hartikap/ProjectWork/README.md

# ProjectWork
Ohjelmistokehitys-koulutuksen projektityö
