hartikap/ProjectWork/Linkkejä.txt

USB-funktio generaattori:
http://tuomasnylund.fi/drupal6/content/ad9833-based-usb-function-generator
- Voisi liittää suoraan raspberryyn
	-> Python koodi tms ohjaamiseen

Patchwerk: Multi-User Network Control of a Massive Modular Synthesizer:
http://www.nime.org/proceedings/2012/nime2012_293.pdf

real-time communication protocol (full-duplex)
https://en.wikipedia.org/wiki/WebSocket

Raspberry pi documentation:
https://www.raspberrypi.org/documentation/hardware/raspberrypi/
I2S on raspi:
http://www.tjaekel.com/T-DAC/files/RPi-Bplus_guideline.pdf

Eurorack specs and examples:
http://www.doepfer.de/DIY/a100_diy.htm

https://www.thonk.co.uk/shop/caserail/
http://www.sdiy.info/w/Eurorack_DIY_parts
http://clicksclocks.de/
http://www.thomann.de/fi/doepfer_a100_diy_kit_1.htm
http://www.thomann.de/fi/doepfer_kabelsatz_fuer_diy_synth_kit.htm
http://www.instructables.com/id/Build-your-own-low-cost-Eurorack-Suitcase/

Eurorack explained:
https://www.youtube.com/watch?v=SBTiaGG6T6A

On synthesizer theory&applications:
http://electronotes.netfirms.com/free.htm

VCO:
http://www.birthofasynth.com/Thomas_Henry/Pages/VCO-1.html#Voltage_Controlled_Oscillator:_VCO-1

Making PCBs:
http://www.electricstuff.co.uk/pcbs.html
