hartikap/ProjectWork/WWWAMS_block-diagram1.pdf

Web Application -controlled Analog Modular Synthesizer (”WAMS”)

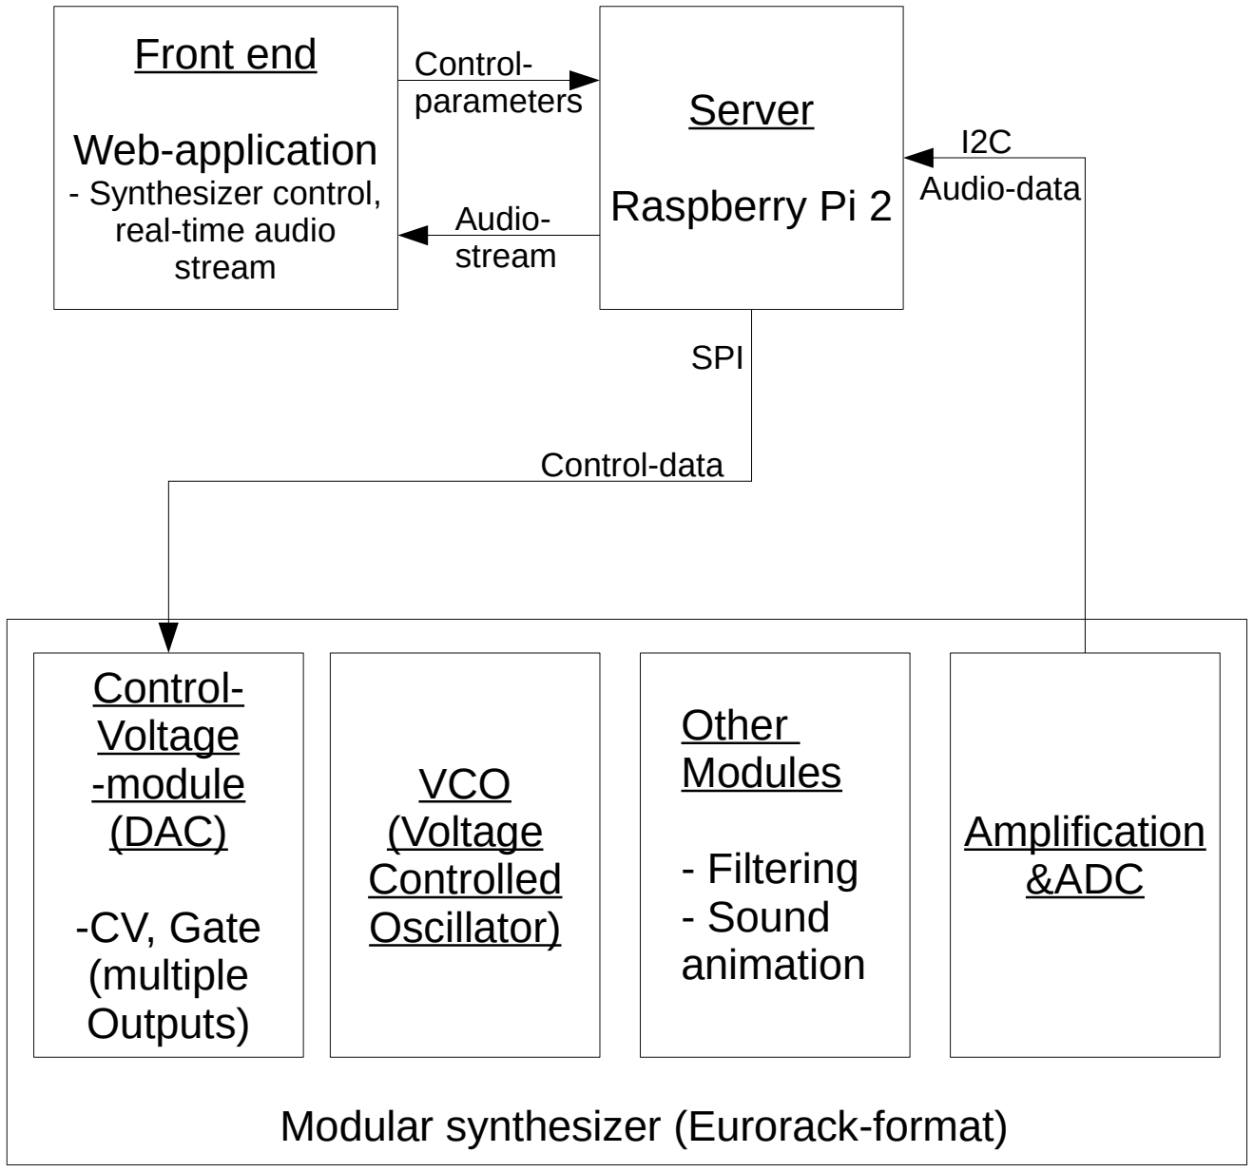
[picture p1: figure]
Front end; Web-application - Synthesizer control, real-time audio stream; Server; Raspberry Pi 2; Control- Voltage -module (DAC); -CV, Gate (multiple Outputs); VCO (Voltage Controlled Oscillator); SPI; Audio- stream; Control- parameters; Amplification &ADC; Modular synthesizer (Eurorack-format); Other Modules; - Filtering - Sound animation; Audio-data; Control-data
