hartikap/ProjectWork/Hardware/VCO-1/VCO1_PCB-layout.pdf

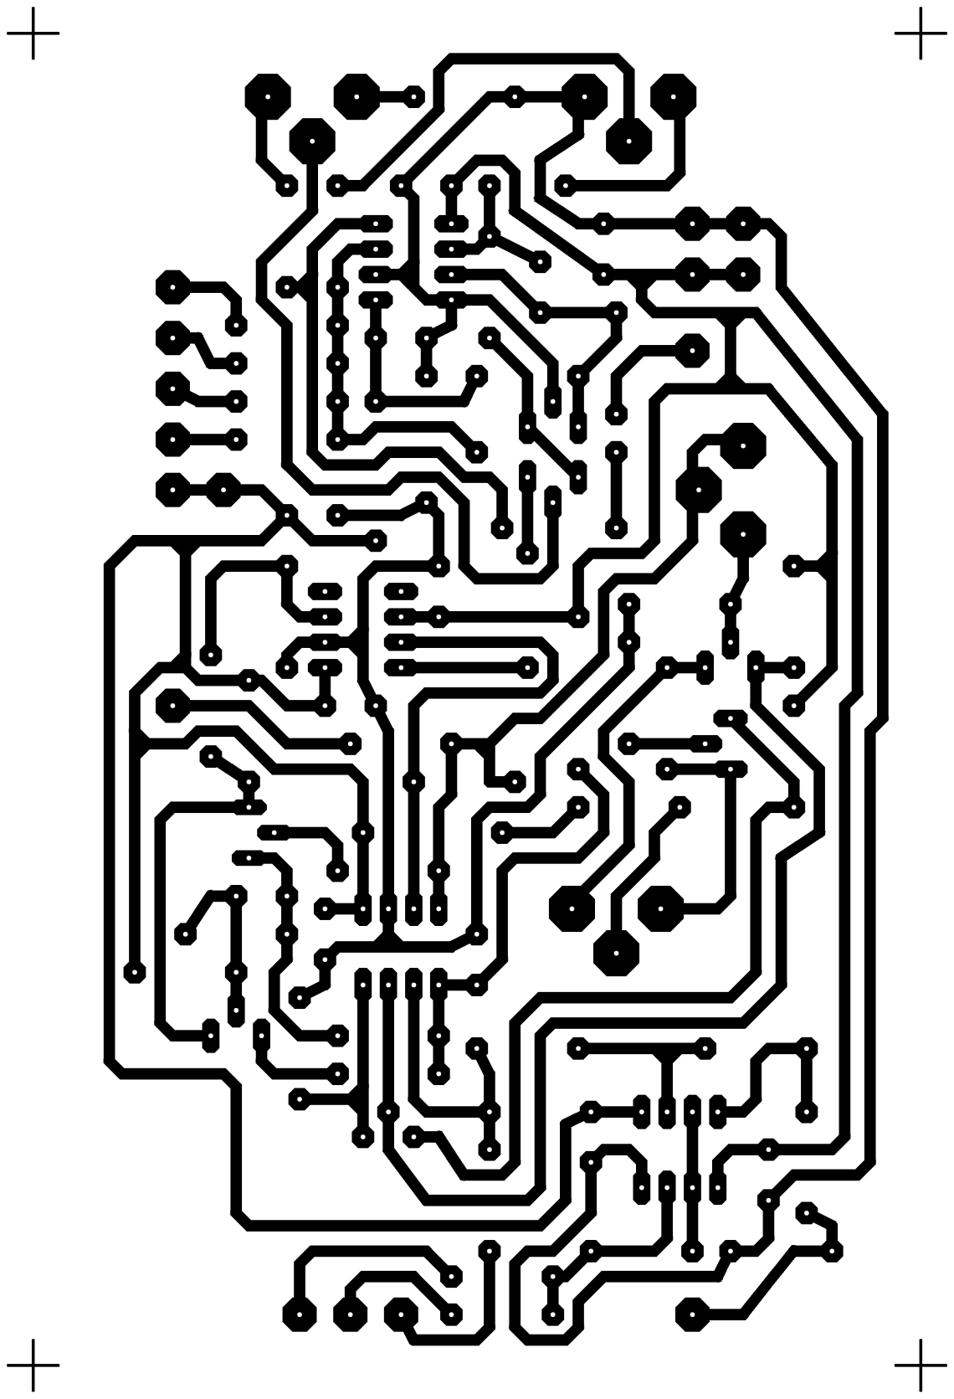
[picture p2: figure]
