hartikap/ProjectWork/Hardware/ADC-Board/Bottom.png

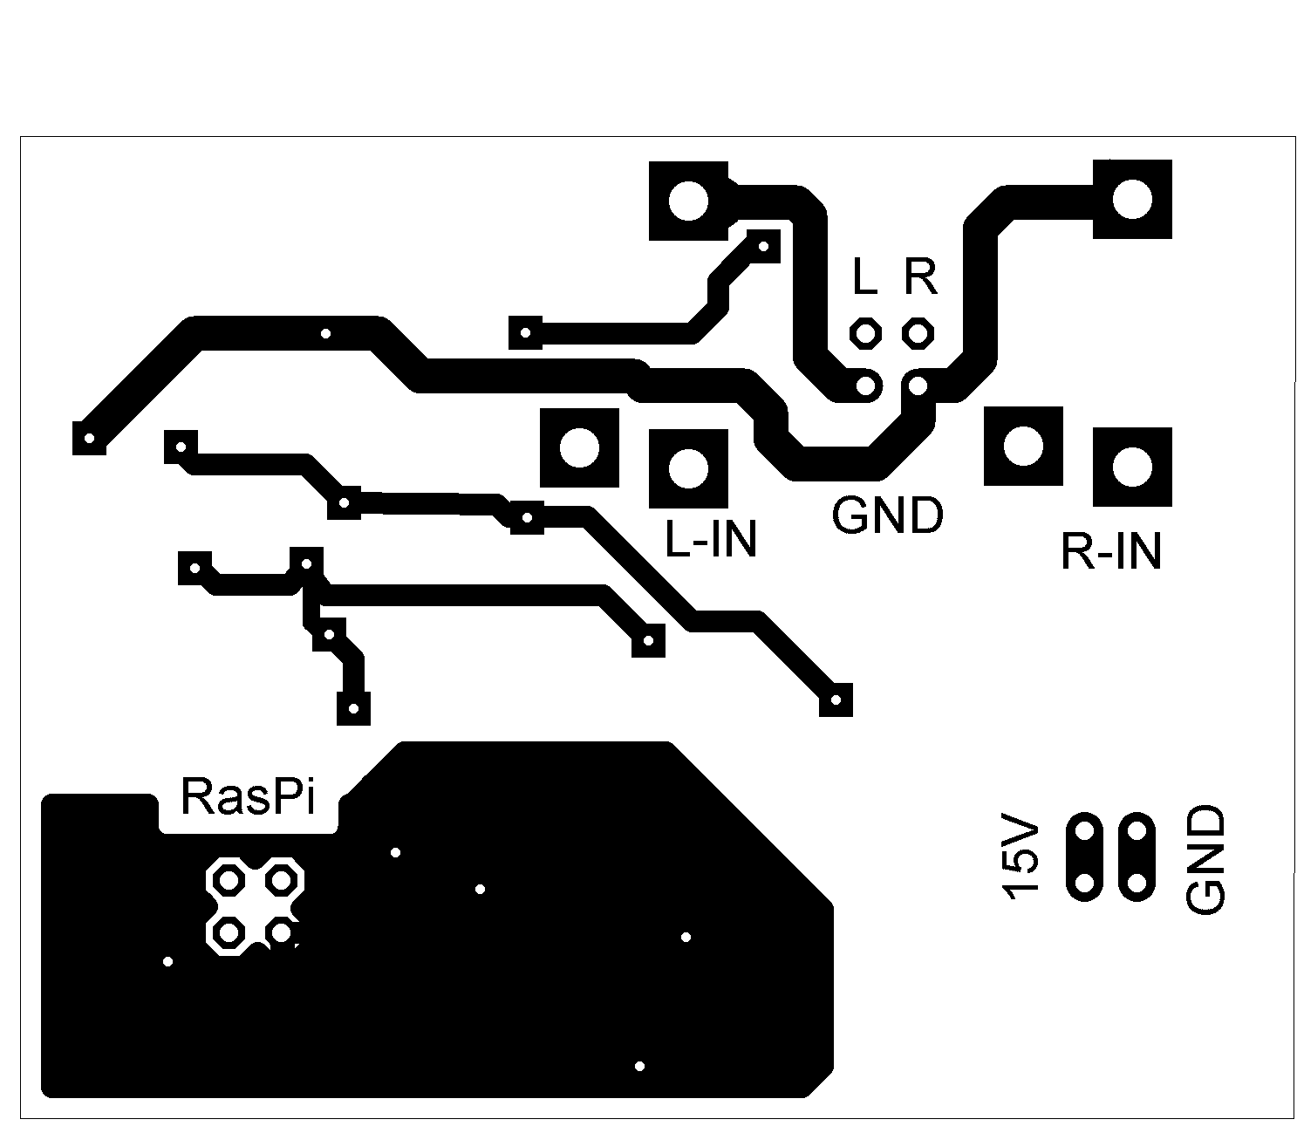
Hardware/ADC-Board/Bottom.png
