hartikap/ProjectWork/Hardware/ADC-Board/Placing.png

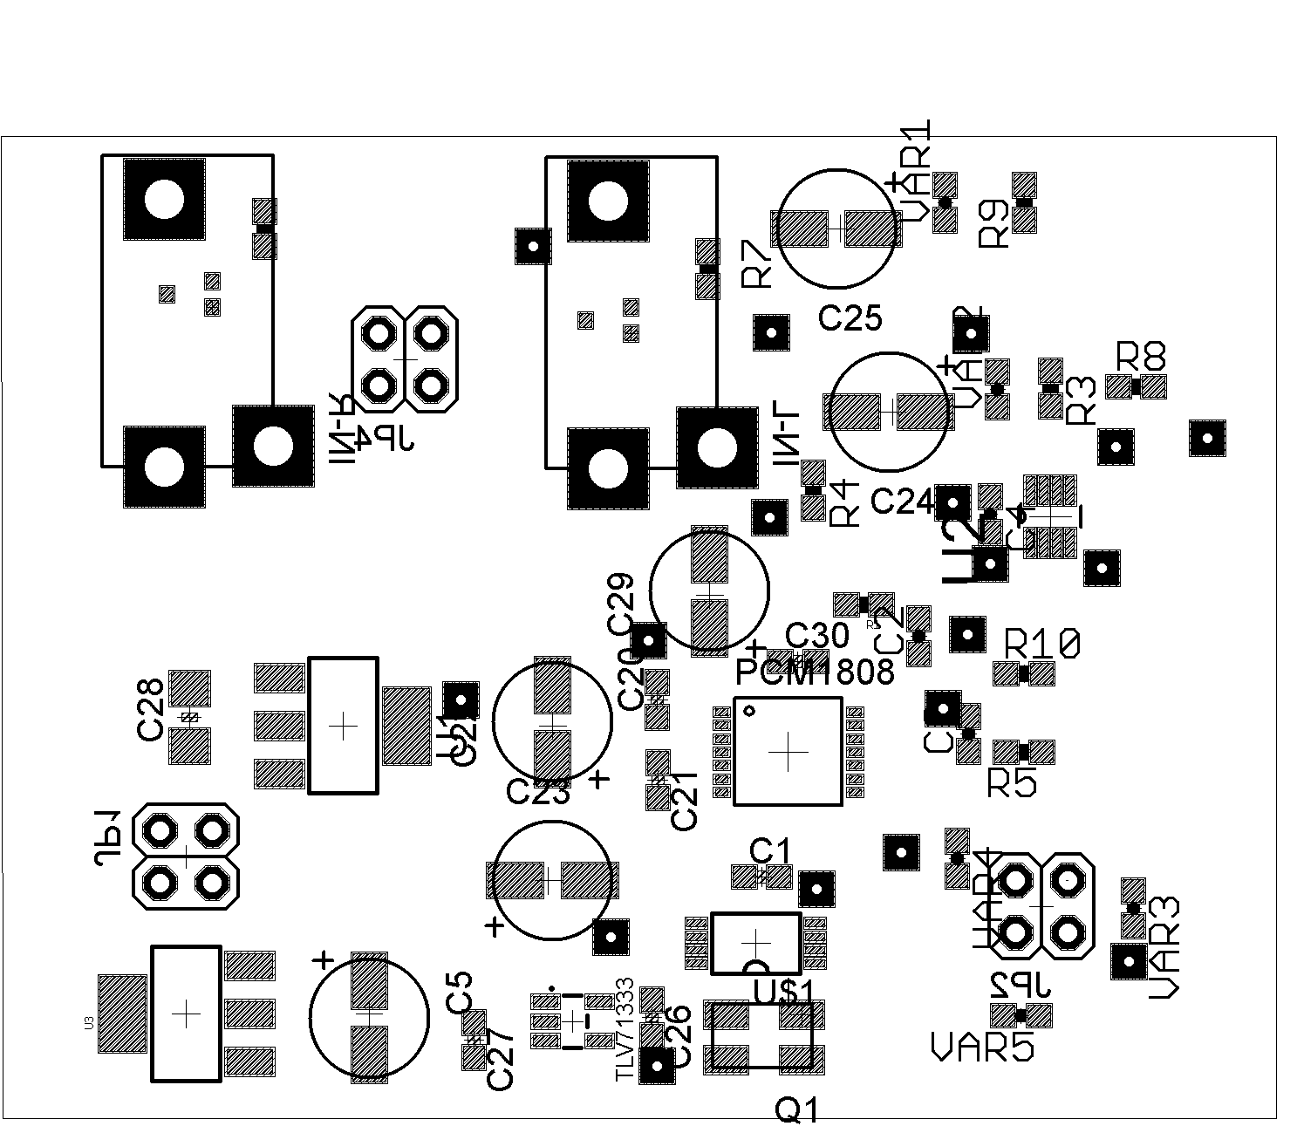
Hardware/ADC-Board/Placing.png
