hartikap/ProjectWork/Hardware/ADC-Board/schematics.png

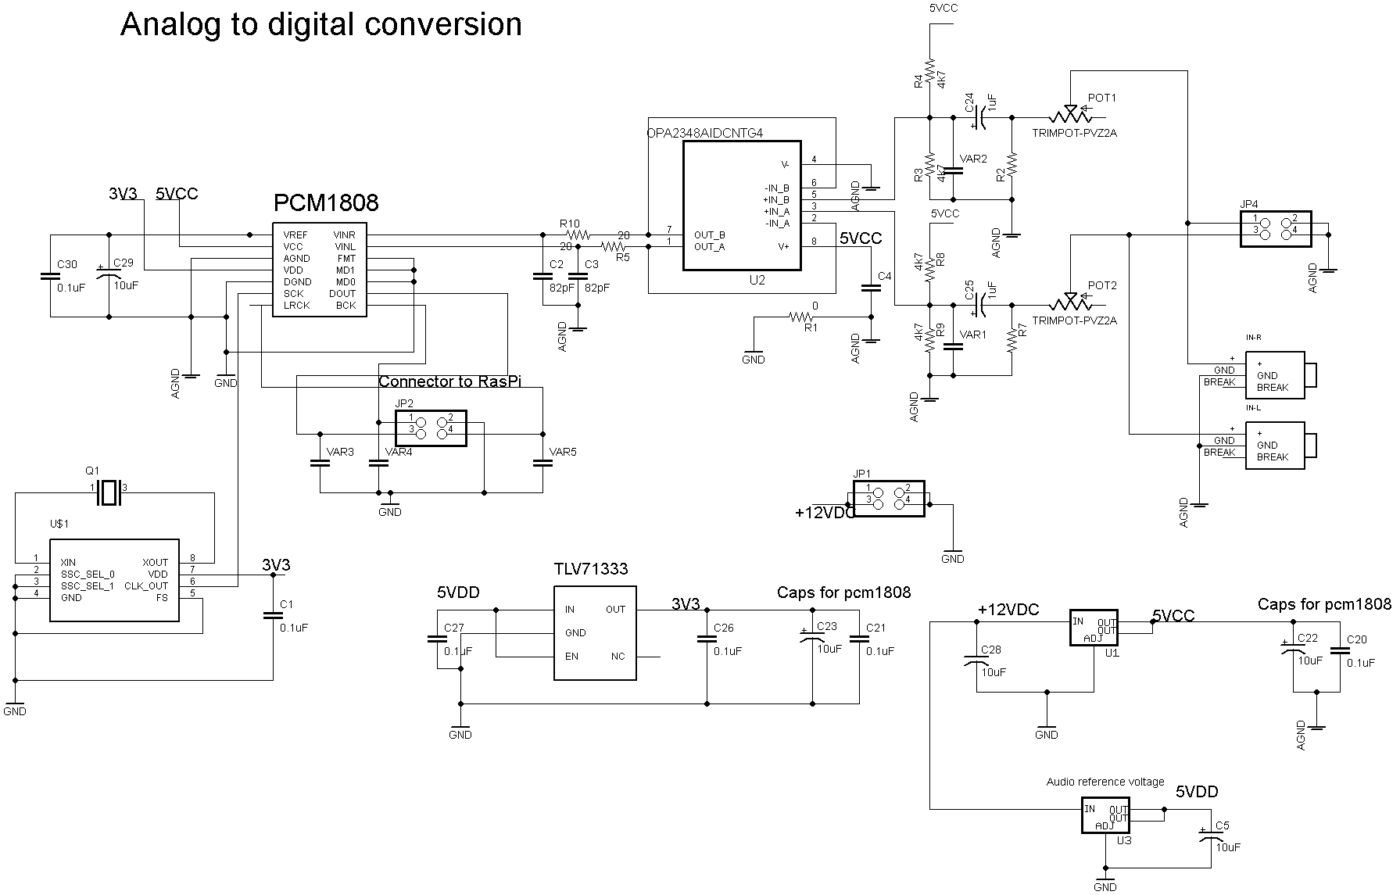
Hardware/ADC-Board/schematics.png
