hartikap/ProjectWork/Hardware/ADC-Board/Top.png

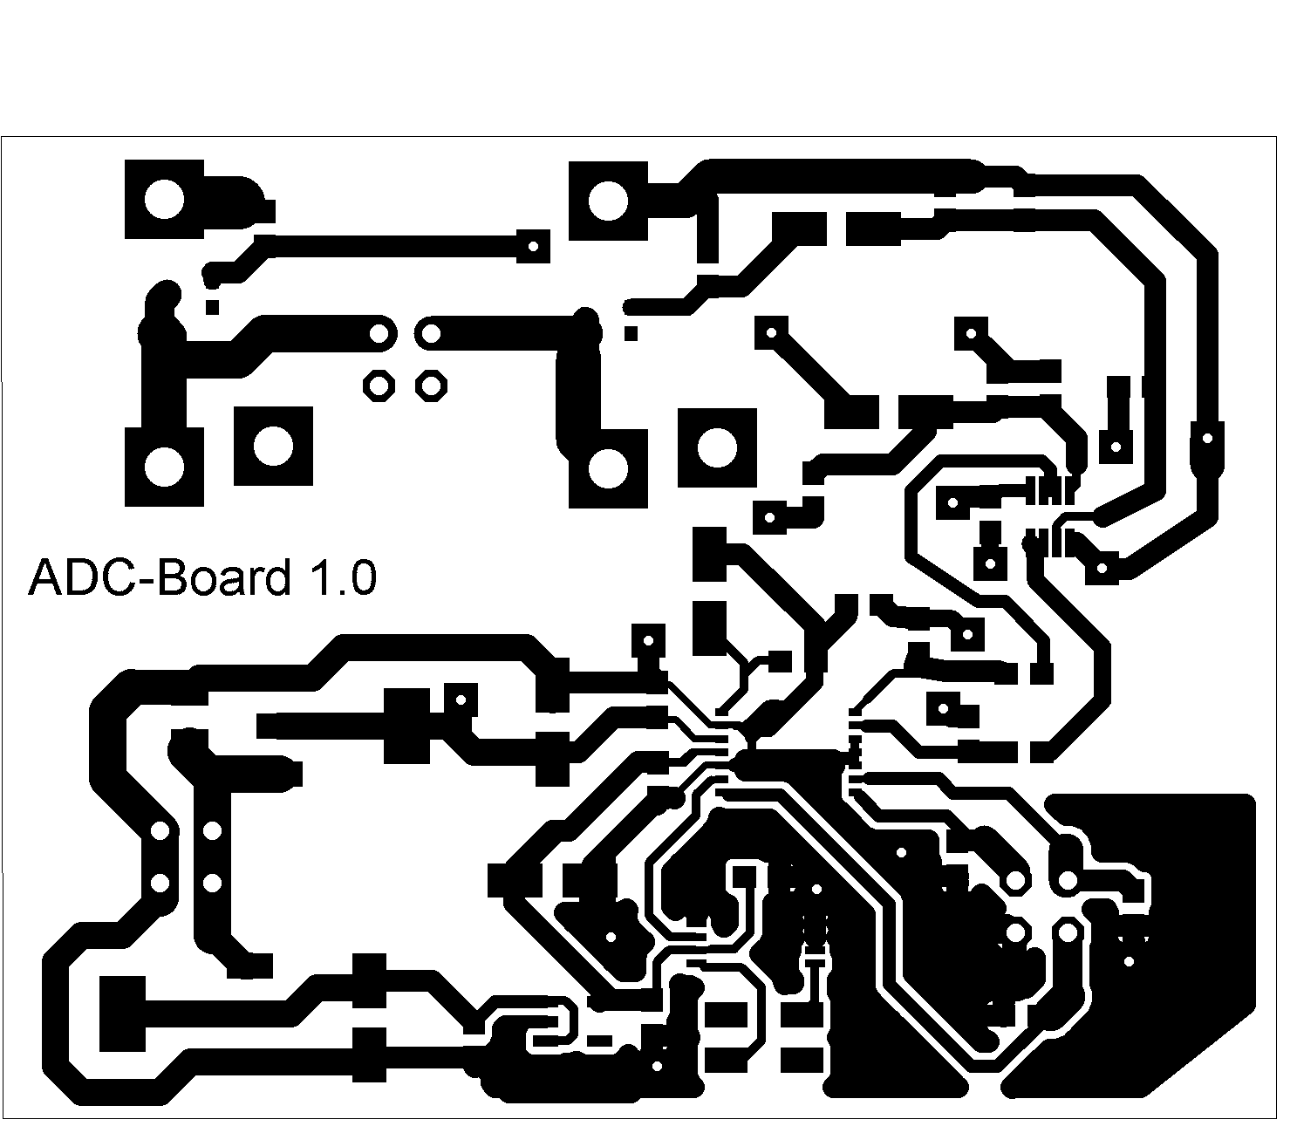
Hardware/ADC-Board/Top.png
