hartikap/ProjectWork/Hardware/CV-voltage conditioning/Bottom.png

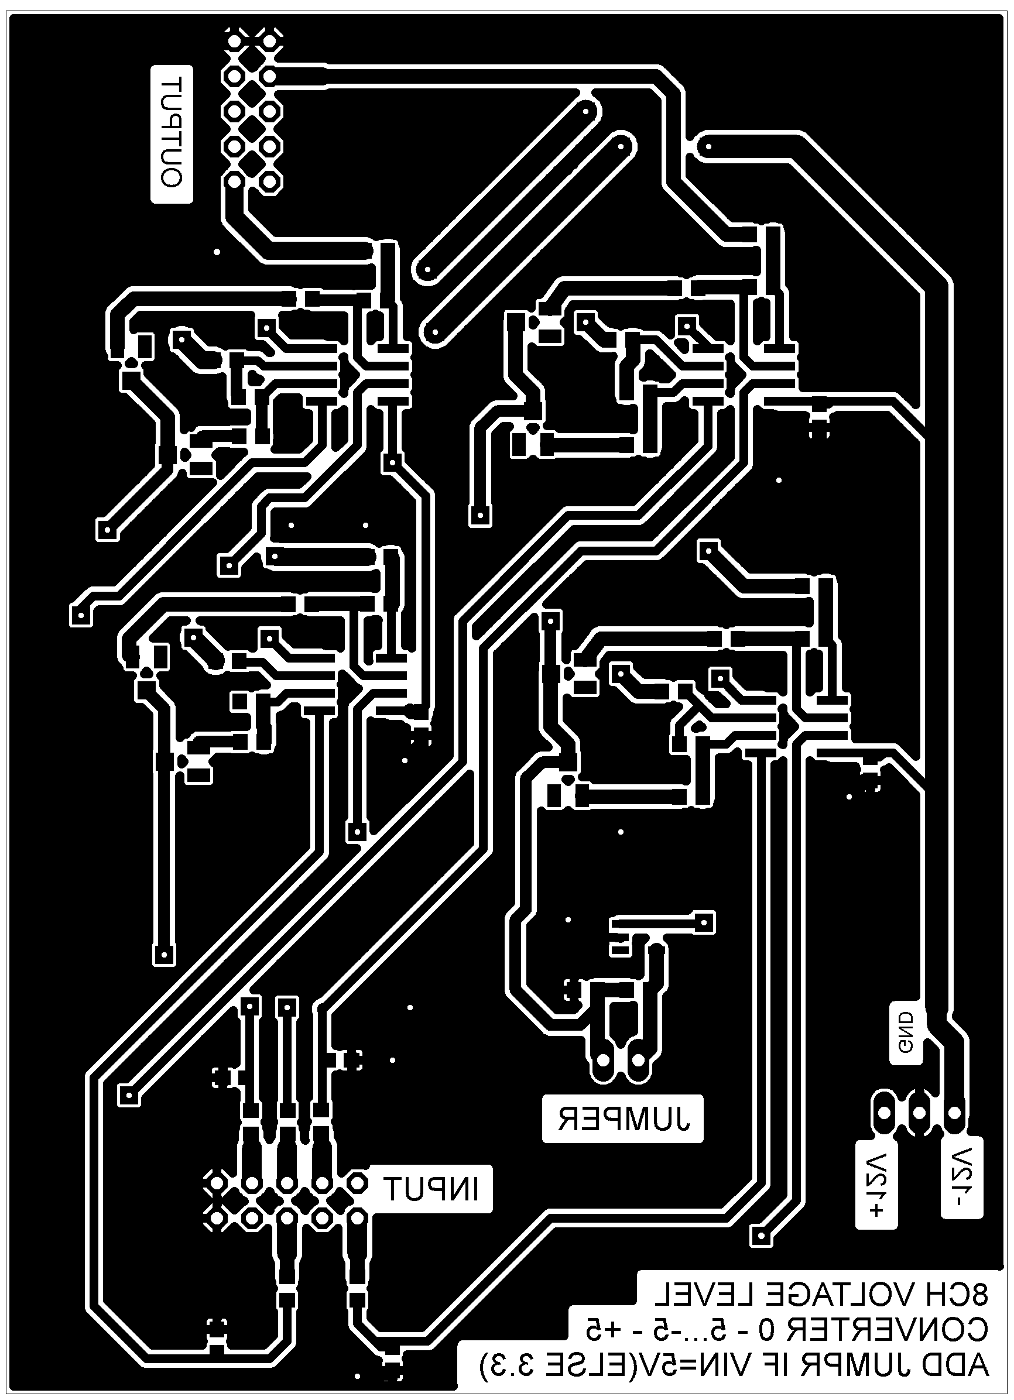
Hardware/CV-voltage conditioning/Bottom.png
