hartikap/ProjectWork/Hardware/CV-voltage conditioning/Bottom_placement.png

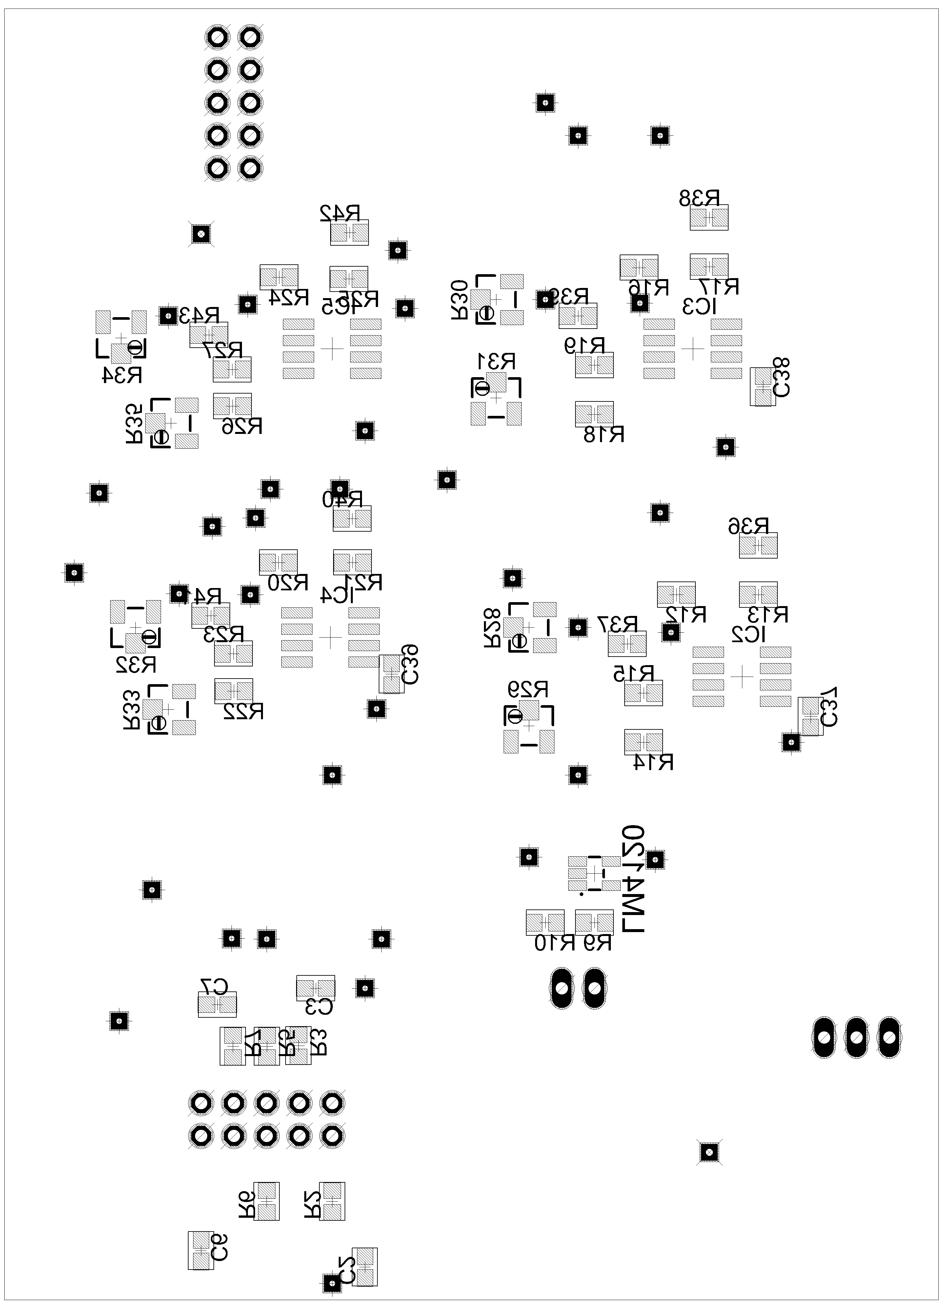
Hardware/CV-voltage conditioning/Bottom_placement.png
