hartikap/ProjectWork/Hardware/Farnell-parts.ods

Farnell order-list
For CV-module: | Order id | amount | Price/pc | Price total | datasheet
MCP4726A0T-E/CH Digital to Analogue Converter, 12 bit, Serial, 2.7V to 5.5V, SOT-23, 6 | 1925047 | 1 | 0,997 | 0,997 | http://www.farnell.com/datasheets/1780742.pdf
LM358ADR OP AMP, DUAL LOW POWER, SOIC8 | 7527007 | 20 | 0,1015 | 2,03 | http://www.farnell.com/datasheets/1874566.pdf
LM4120IM5-5.0/NOPB Voltage Reference | 2400687 | 2 | 1,05 | 2,1 | http://www.farnell.com/datasheets/1882702.pdf
Surface Mount Tantalum Capacitor, T491 Series, 10 µF, ± 10%, 16 V, 1206 | 1457414 | 5 | 0,318 | 1,59
SMD Multilayer Ceramic Capacitor, 0.022 µF, ± 10%, X5R, 10 V, 0603 | 2112848 | 10 | 0,0673 | 0,673
SMD Multilayer Ceramic Capacitor, 0.1 µF, ± 10%, X5R, 10 V, 0603 | 2470450 | 40 | 0,0311 | 1,244
AC/DC Power Supply, Raspberry Pi, Euro, 90 V, 264 V, 5 W, 5 V, 1 A | 2254794 | 1 | 4,03 | 4,03
Analogue to Digital Converter, 24 bit, 96 kSPS | 1754965 | 1 | 2,22 | 2,22 | http://www.farnell.com/datasheets/1764047.pdf
Surface Mount Chip Resistor, Thick Film, RC Series, 100 kohm, 0603 | 2309107 | 50 | 0,0033 | 0,165
Surface Mount Chip Resistor, Thick Film, RC Series, 1 kohm, 0603 | 2309108 | 50 | 0,0047 | 0,235
Surface Mount Chip Resistor, Thick Film, MC Series, 10 kohm, 0603 | 9330399 | 50 | 0,012 | 0,6
POTENTIOMETER, 1KOHM | 2219385 | 8 | 0,25 | 2
SMD Resistor, Thick Film, MC Series, 9.53 kohm, 63 mW, ± 1%, 50 V | 1170887 | 20 | 0,014 | 0,28
Fixed LDO Voltage Regulator, 6.4V to 18V, 1.2V Dropout, 5Vout, 1Aout, sot223 | 1825292 | 2 | 0,571 | 1,142 | http://www.farnell.com/datasheets/1696797.pdf
Resistor, Thick Film, CR Series, 20 kohm, 100 mW, ± 1%, 50 V, 0603 | 2333523 | 30 | 0,0486 | 1,458
SMD Aluminium Electrolytic Capacitor, WCAP-ASLL Series, 1 µF, 50 V, Radial Can | 2466226 | 5 | 0,142 | 0,71
SMD Aluminium Electrolytic Capacitor, WCAP-ASLI Series, 10 µF, 16 V, Radial Can | 2466275 | 5 | 0,158 | 0,79
TLV71333PDBVR Fixed LDO Voltage Regulator, 1.4V to 5.5V, 230mV Dropout, 3.3Vout, 150mAout, SOT-23-5 | 2463932 | 5 | 0,197 | 0,985 | http://www.farnell.com/datasheets/1888877.pdf
CDCS502PW CLOCK GENERATOR, 32MHZ, TSSOP-8 | 2492599 | 1 | 2,66 | 2,66 | http://www.farnell.com/datasheets/1919071.pdf
XTAL, 12.288MHZ, 10PF, SMD, 5.0X3.2 | 1841966 | 1 | 1,11 | 1,11 | http://www.farnell.com/datasheets/1497890.pdf
XTAL, 16.384MHZ, 10PF, SMD, 5.0X3.2 | 1841980 | 1 | 0,865 | 0,865
XTAL, 18.432MHZ, 10PF, SMD, 5.0X3.2 | 1841985 | 1 | 0,659 | 0,659
VISHAY DALE XT49M-18M432 CRYSTAL 18.432MHZ | 1703594 | 1 | 0,352 | 0,352
PRO SIGNAL MJ-2235 Phone Audio Connector, Socket, 3.5 mm, 2, PCB Mount | 1267375 | 2 | 1,37 | 2,74
Surface Mount Chip Resistor, Thick Film, AEC-Q200 ERJ Series, 20 kohm, 100 mW, ± 1%, 75 V | 2059432 | 10 | 0,009 | 0,09
Surface Mount Chip Resistor, Thick Film, RC Series, 39 kohm, 100 mW, ± 1%, 50 V, 0603 | 9238670 | 10 | 0,0067 | 0,067
Header, 5, 2.54 mm, Tin Plated Contacts | 1022253 | 10 | 0,204 | 2,04
SMD Multilayer Ceramic Capacitor, 1 µF, ± 10%, X5R, 10 V, 0603 | 2496916 | 40 | 0,0126 | 0,504
Surface Mount Chip Resistor, Ceramic, MCMR Series, 4.7 kohm, 100 mW, ± 1%, 75 V, 0603 | 2073509 | 20 | 0,0156 | 0,312
 |  |  |  | 0
 |  |  |  | 0
For VCO-1: |  |  |  | 0
Rotary Potentiometer, Conductive Plastic, P160 Series, 100 kohm, Linear | 1760795 | 10 | 1,04 | 10,4
MULTICOMP CR-MS-2 KNOB, SOFT TOUCH, SPLINED SHAFT, YEL | 1440003 | 10 | 0,474 | 4,74
Rotary Potentiometer, Cermet, 93 Series, 100 ohm, Linear | 2321801 | 1 | 6,44 | 6,44
2N3904BU Bipolar (BJT) Single Transistor, NPN | 1700648 | 10 | 0,0982 | 0,982
2N3906 Bipolar (BJT) Single Transistor, High Speed Switching, PNP | 1574372 | 5 | 0,2 | 1
LM13700N/NOPB Transconductance Amplifier, Dual, 2, 18 V, 2 MHz, -5 V, 5 V, DIP | 1651866 | 2 | 1,47 | 2,94
TL072IP Operational Amplifier, Dual, 3 MHz, 2, 13 V/µs, 7V to 36V, DIP, 8 | 1459704 | 5 | 0,883 | 4,415
1000PF 1% 250V Film Capacitor, FSC/EX Series, 1000 pF, ± 1%, PS (Polystyrene), 250 V | 9520651 | 2 | 2,14 | 4,28
IC SOCKET, DIP, 8POS, TH | 2445620 | 10 | 0,205 | 2,05
Multilayer Ceramic Capacitor, Mono-Kap Series, 1000 pF, ± 5%, C0G / NP0, 50 V | 1141771 | 5 | 0,253 | 1,265
Multilayer Ceramic Capacitor, MC Series, 47 pF, ± 5%, C0G / NP0, 100 V | 2395776 | 10 | 0,0889 | 0,889
Multilayer Ceramic Capacitor, MC Series, 0.22 µF, ± 10%, X7R, 50 V | 2395774 | 5 | 0,164 | 0,82
Multilayer Ceramic Capacitor, Mono Axial, A Series, 0.01 µF, ± 10%, X7R, 50 V | 1902252 | 10 | 0,19 | 1,9
Through Hole Resistor, MRS25 Series, 47 ohm, 600 mW, ± 1%, 350 V, Axial Leaded | 9468510 | 10 | 0,0672 | 0,672
Through Hole Resistor, MF25 Series, 820 ohm, 250 mW, ± 1%, 250 V, Axial Leaded | 9342265 | 10 | 0,0776 | 0,776
Through Hole Resistor, LR Series, 1 kohm, 600 mW, ± 1%, 350 V, Axial Leaded | 2330035 | 10 | 0,063 | 0,63
Through Hole Resistor, LR Series, 2 kohm, 250 mW, ± 1%, 200 V, Axial Leaded | 2329911 | 10 | 0,053 | 0,53
Through Hole Resistor, CFR Series, 10 kohm, 250 mW, ± 5%, 200 V, Axial Leaded | 2329474 | 10 | 0,034 | 0,34
Through Hole Resistor, MF12 Series, 5.1 kohm, 125 mW, ± 1%, 200 V, Axial Leaded | 9343318 | 5 | 0,0245 | 0,1225
Through Hole Resistor, MFR Series, 18 kohm, 400 mW, ± 1%, 200 V, Axial Leaded | 1565285 | 10 | 0,034 | 0,34
Through Hole Resistor, MFR Series, 22 kohm, 400 mW, ± 1%, 200 V, Axial Leaded | 1565295 | 10 | 0,037 | 0,37
Through Hole Resistor, LR Series, 20 kohm, 250 mW, ± 1%, 200 V, Axial Leaded | 2329897 | 10 | 0,055 | 0,55
Through Hole Resistor, MFR Series, 27 kohm, 400 mW, ± 1%, 200 V, Axial Leaded | 1565299 | 10 | 0,0477 | 0,477
Through Hole Resistor, MFR Series, 100 kohm, 400 mW, ± 1%, 200 V, Axial Leaded | 1565269 | 10 | 0,037 | 0,37
Through Hole Resistor, MFR Series, 1 Mohm, 400 mW, ± 1%, 200 V, Axial Leaded | 1565292 | 10 | 0,037 | 0,37
Through Hole Resistor, CFR Series, 2.2 Mohm, 250 mW, ± 5%, 200 V, Axial Leaded | 2329510 | 10 | 0,034 | 0,34
Through Hole Resistor, CFR Series, 1.5 Mohm, 250 mW, ± 5%, 200 V, Axial Leaded | 2329492 | 10 | 0,037 | 0,37
Through Hole Resistor, CFR Series, 3.3 Mohm, 330 mW, ± 5%, 250 V, Axial Leaded | 2329676 | 10 | 0,0396 | 0,396
Phone Audio Connector, Socket, 3.5 mm, 2, Panel Mount | 1340604 | 16 | 0,766 | 12,256
TE CONNECTIVITY / CITEC LT300014T261K0J RESISTOR, TEMPERATURE SENSING, 1K | 1174306 | 2 | 1,08 | 2,16
 |  |  |  | 0
 |  |  |  | 0
 |  |  |  | 0
 |  |  |  | 0
 |  |  |  | 0
 |  |  |  | 0
 |  |  |  | 97,8385 | Total
Lisätilaus
SMD Multilayer Ceramic Capacitor, 0.1 µF, ± 10%, X7R, 50 V, 0603 | 2496834 | 40 | 0,0126 | 0,504
SMD Multilayer Ceramic Capacitor, 0.022 µF, ± 10%, X7R, 50 V, 0603 | 1658869 | 20 | 0,0336 | 0,672
MCP6002-I/P Operational Amplifier, Dual, 1 MHz, 2, 0.6 V/µs, 1.8V to 6V, DIP, 8 | 1292245 | 10 | 0,414 | 4,14
OPA2348AIDCNT Operational Amplifier, Dual, 1 MHz, 2, 0.5 V/µs, 2.1V to 5.5V, SOT-23, 8 | 1207098 | 4 | 0,852 | 3,408
VARISTOR,SUPP,ESD PROTECT,20V,0603 | 1838966 | 20 | 0,129 | 2,58
Surface Mount Chip Resistor, Thick Film, AEC-Q200 ERJ Series, 20 ohm, 100 mW, ± 1%, 75 V | 2059261 | 20 | 0,009 | 0,18
SMD Multilayer Ceramic Capacitor, MC Series, 82 pF, ± 5%, C0G / NP0, 50 V, 0603 [1608 Metric] | 1759065 | 10 | 0,0119 | 0,119
Surface Mount Chip Resistor, Ceramic, MCMR Series, 4.7 kohm, 100 mW, ± 1%, 75 V, 0603 | 2073509 | 30 | 0,0156 | 0,468
TRIMMER, SMD, 4K7 | 1771724 | 2 | 0,292 | 0,584
Through Hole Resistor, MFR Series, 75 ohm, 500 mW, ± 1%, 250 V, Axial Leaded | 1099864 | 50 | 0,0255 | 1,275
Through Hole Resistor, MFR Series, 47 ohm, 500 mW, ± 1%, 350 V, Axial Leaded | 1099858 | 20 | 0,0571 | 1,142
Electrolytic Capacitor, MCGPR Series, 22 µF, ± 20%, 25 V, 5 mm, Radial Leaded | 9451161 | 20 | 0,043 | 0,86
MOSFET Transistor, N Channel, 400 mA, 60 V, 1.2 ohm, 10 V, 2.1 V | 1017689 | 5 | 0,184 | 0,92
MOSFET Transistor, N Channel, 1.4 A, 30 V, 0.119 ohm, 10 V, 1.6 V | 2432720 | 5 | 0,0622 | 0,311
2N4401TF Bipolar (BJT) Single Transistor, NPN, 40 V, 250 MHz, 625 mW | 2453755 | 5 | 0,056 | 0,28
 |  |  |  | 0
 |  |  |  | 0
 |  |  |  | 17,443
Lisätilaus 2
50k potikka
Liitin muuntaja – PCB
