hartikap/ProjectWork/Hardware/VCO-1/VCO1_Parts_Placement.pdf

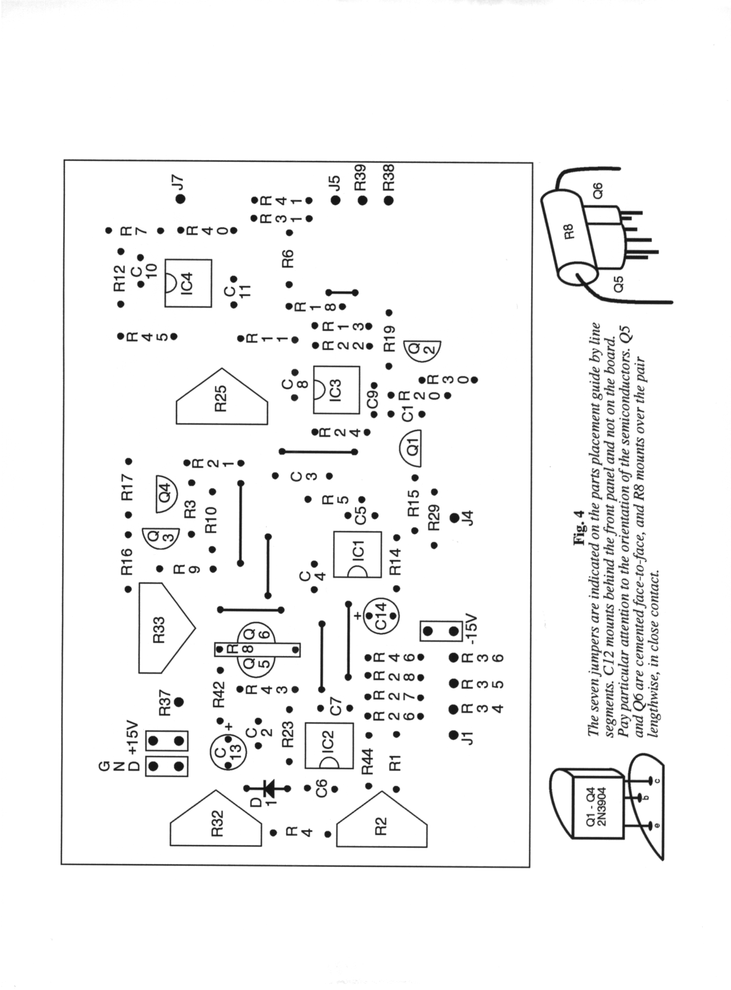
[picture p9: page 1]
