hartikap/ProjectWork/Hardware/ADC-Board/ADC-Board-schematics.brd

## EAGLE design Hardware/ADC-Board/ADC-Board-schematics.brd (2016-03-11)

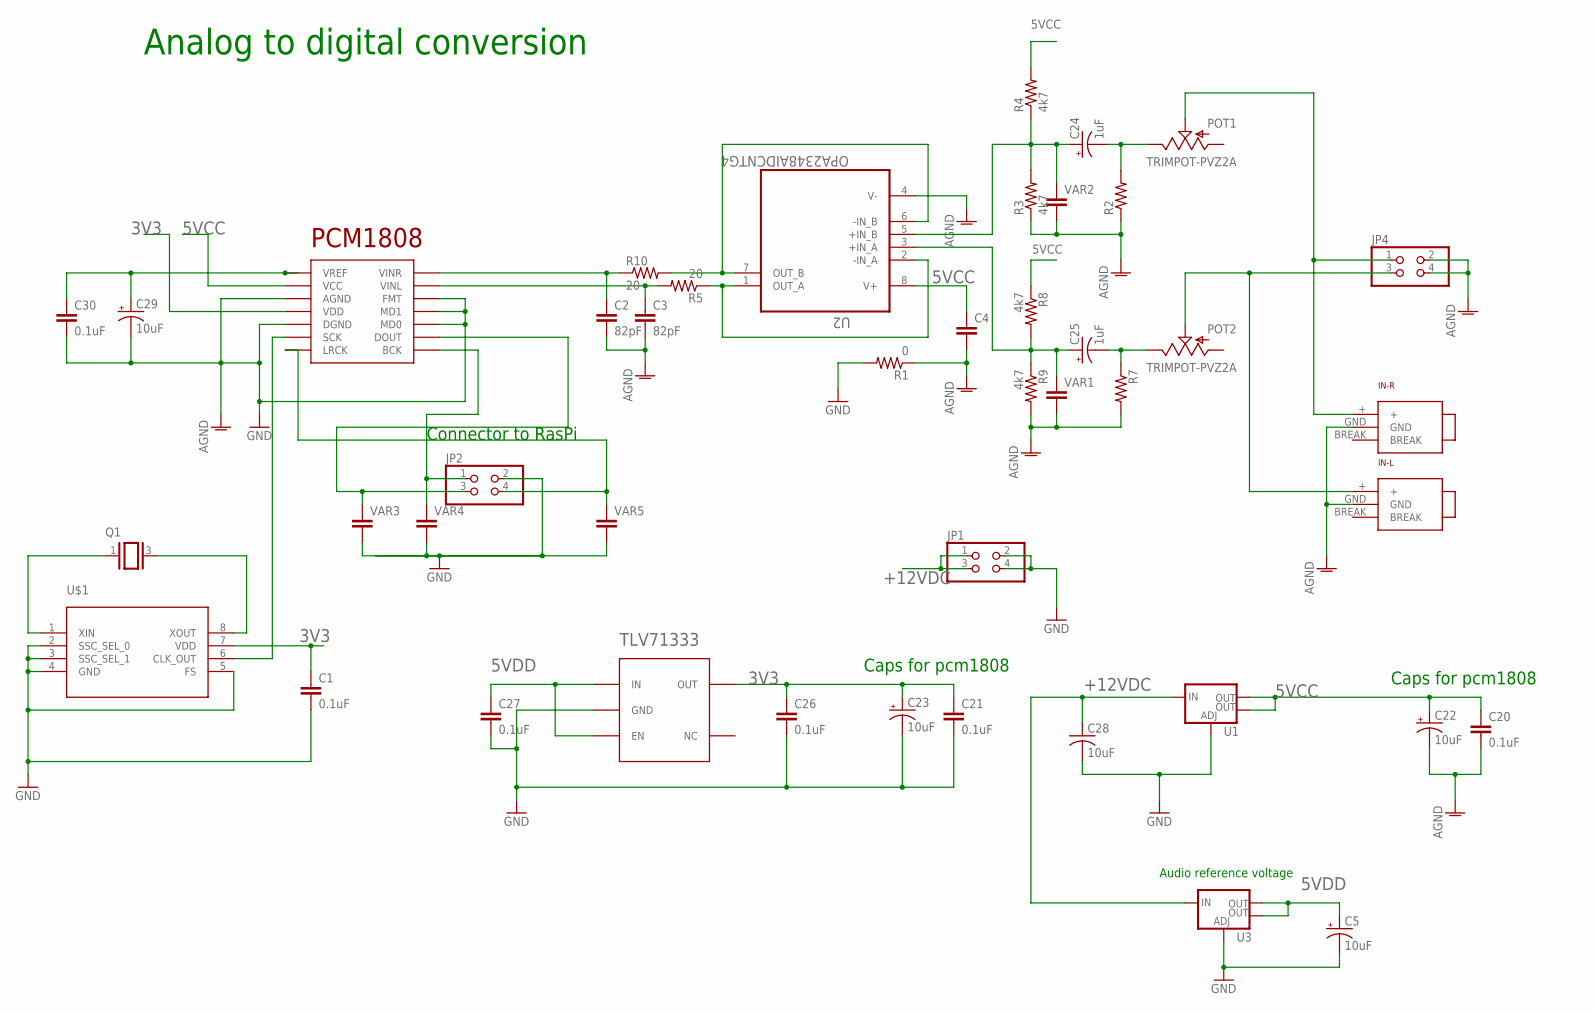
[picture p10: schematic ADC-Board-schematics.sch]

Parts:
C1, C20, C21, C26, C27, C30: 0.1uF; C0603
C2, C3: 82pF; 0603-CAP
C4: CAP0603-CAP; 0603-CAP
C5, C22, C23, C29: 10uF; RADIALCAN4MM
C24, C25: 1uF; RADIALCAN4MM
C28: 10uF; C1206
IN-L: 3MM5-PLUG
IN-R: 3MM5-PLUG
JP1, JP2, JP4: PINHD-2X2; 2X02
PCM1808: PCM1808PW; R-PDSO-G14
POT1, POT2: TRIMPOT-PVZ2A; PVZ2A
Q1: XTAL; 5X3CRYSTAL
R1: 0; 0603-RES
R2, R7: RESISTOR0603-RES; 0603-RES
R3, R4, R8, R9: 4k7; 0603-RES
R5, R10: 20; 0603-RES
TLV71333: TVL713; SOT23-5
U1, U3: V_REG_LM1117SOT223; SOT223
U2: OPA2348AIDCNTG4; SOT65P280X145-8N
U$1: CDCS502TSSOP-8; TSSOP-8
VAR1, VAR2, VAR3, VAR4, VAR5: CAP0603-CAP; 0603-CAP

Connections:
3V3: C1.1, C21.1, C23.1 (+), C26.1, PCM1808.4 (VDD), TLV71333.5 (OUT), U$1.7 (VDD)
5VCC: C4.1, C20.1, C22.1 (+), PCM1808.3 (VCC), R4.2, R8.1, U1.2 (OUT), U1.4 (OUT), U2.8 (V+)
5VDD: C5.1 (+), C27.1, TLV71333.1 (IN), TLV71333.3 (EN), U3.2 (OUT), U3.4 (OUT)
+12VDC: C28.1, JP1.1, JP1.3, U1.3 (IN), U3.3 (IN)
AGND: C2.2, C3.2, C4.2, IN-L.GND, IN-R.GND, JP4.2, JP4.4, R1.1, R2.1, R3.1, R7.2, R9.2, U2.4 (V-), VAR1.2, VAR2.2
GND: C1.2, C5.2 (-), C20.2, C21.2, C22.2 (-), C23.2 (-), C26.2, C27.2, C28.2, C29.2 (-), C30.2, JP1.2, JP1.4, JP2.2, PCM1808.2 (AGND), PCM1808.5 (DGND), PCM1808.10 (MD0), PCM1808.11 (MD1), PCM1808.12 (FMT), R1.2, TLV71333.2 (GND), U1.1 (ADJ), U3.1 (ADJ), U$1.2 (SSC_SEL_0), U$1.3 (SSC_SEL_1), U$1.4 (GND), U$1.5 (FS), VAR3.2, VAR4.2, VAR5.2
unnamed: JP2.1, PCM1808.8 (BCK), VAR4.1
unnamed: C24.2 (-), POT1.3 (E), R2.2
unnamed: JP2.3, PCM1808.9 (DOUT), VAR3.1
unnamed: C24.1 (+), R3.2, R4.1, U2.5 (+IN_B), VAR2.1
unnamed: R5.1, U2.1 (OUT_A), U2.2 (-IN_A)
unnamed: C3.1, PCM1808.13 (VINL), R5.2
unnamed: C25.2 (-), POT2.3 (E), R7.1
unnamed: C25.1 (+), R8.2, R9.1, U2.3 (+IN_A), VAR1.1
unnamed: R10.2, U2.6 (-IN_B), U2.7 (OUT_B)
unnamed: C2.1, PCM1808.14 (VINR), R10.1
unnamed: JP2.4, PCM1808.7 (LRCK), VAR5.1
unnamed: IN-L.+, JP4.3, POT2.2 (S)
unnamed: IN-R.+, JP4.1, POT1.2 (S)
unnamed: Q1.1, U$1.1 (XIN)
unnamed: Q1.3 (2), U$1.8 (XOUT)
unnamed: C29.1 (+), C30.1, PCM1808.1 (VREF)
unnamed: PCM1808.6 (SCK), U$1.6 (CLK_OUT)

Notes on the sheet:
Caps for pcm1808
Analog to digital conversion
Connector to RasPi
Audio reference voltage

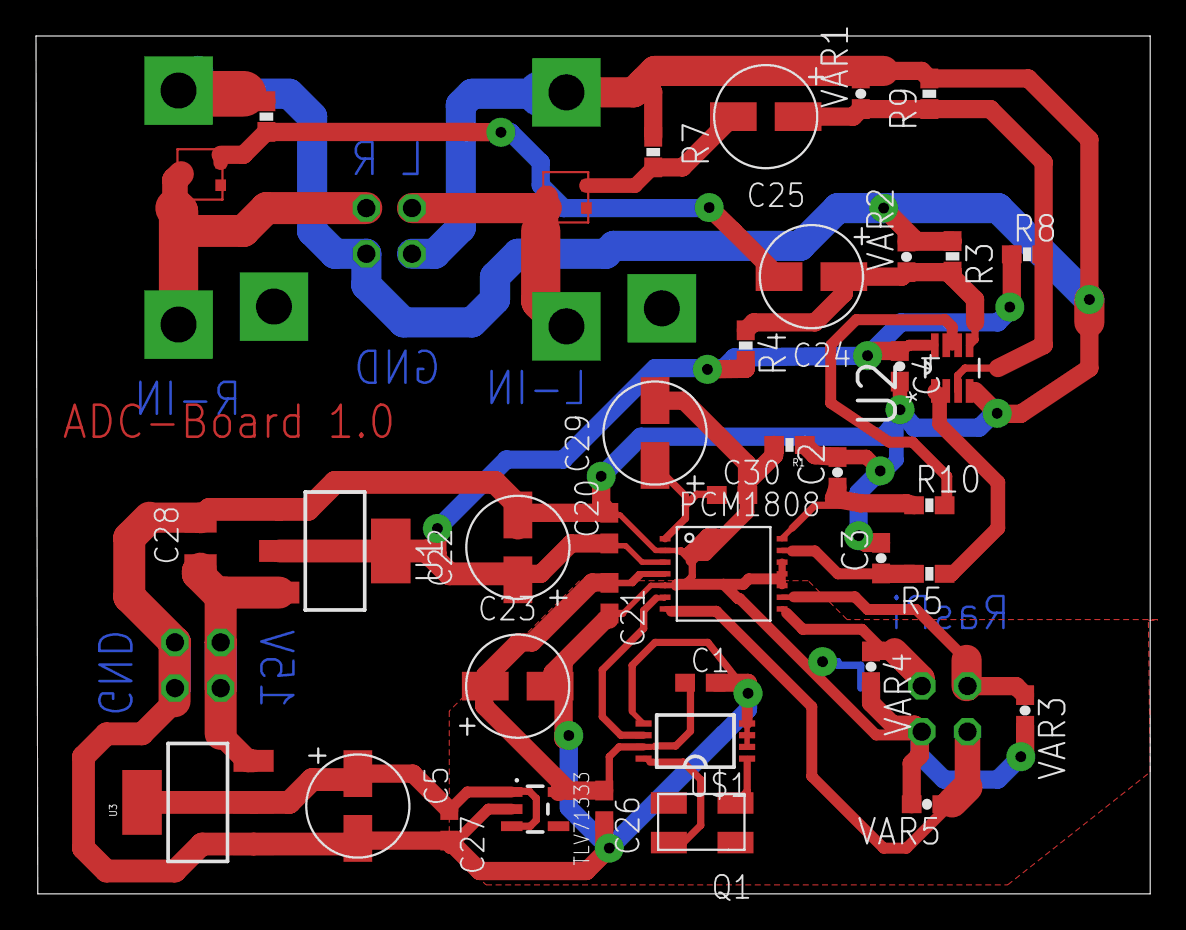
[picture p11: board ADC-Board-schematics.brd from above]

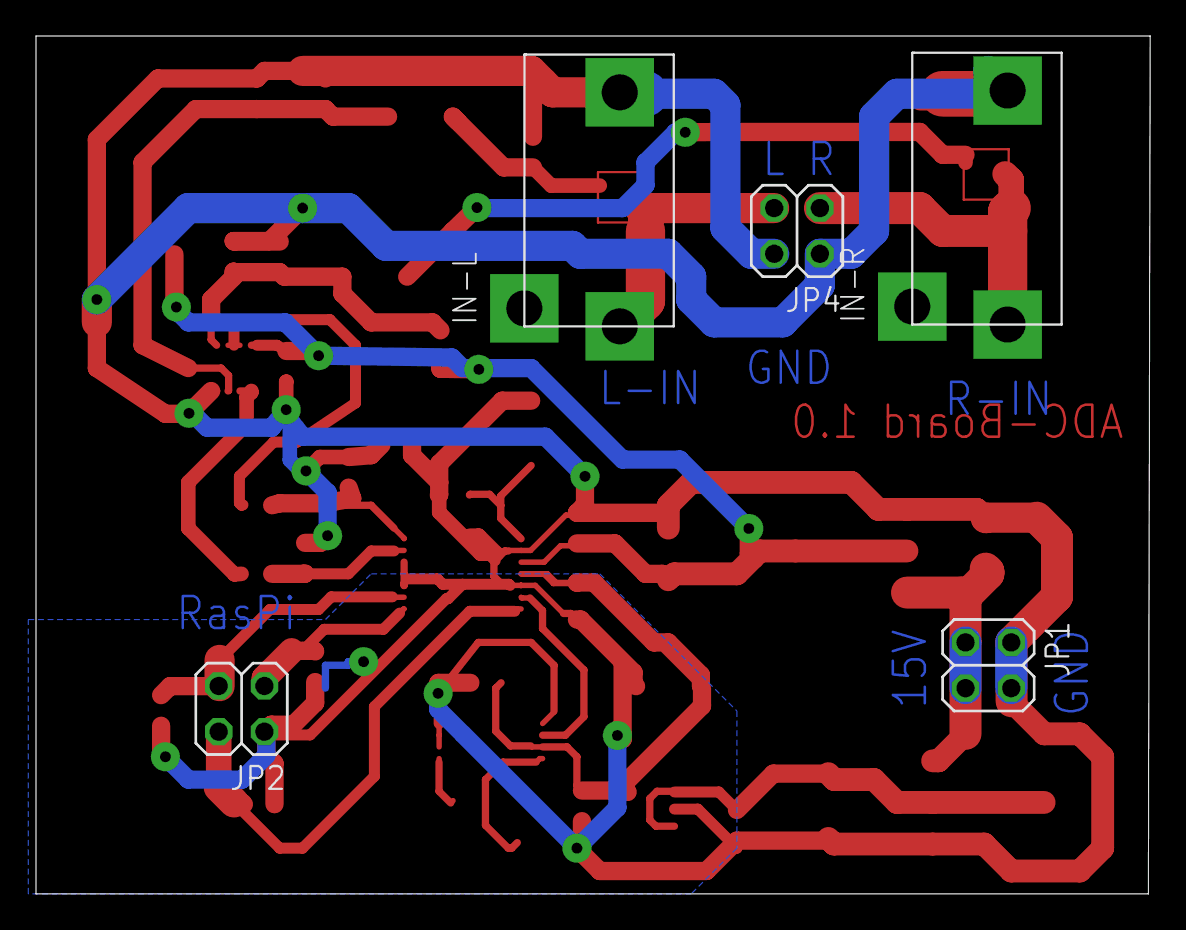
[picture p12: board ADC-Board-schematics.brd from below]

Board: 2 copper layers, 61.9 x 47.7 mm, 44 parts (5 on the bottom side), 23 nets.
