hartikap/ProjectWork/Hardware/CV-voltage conditioning/CV-module-schematics.brd

## EAGLE design Hardware/CV-voltage conditioning/CV-module-schematics.brd (2016-01-15)

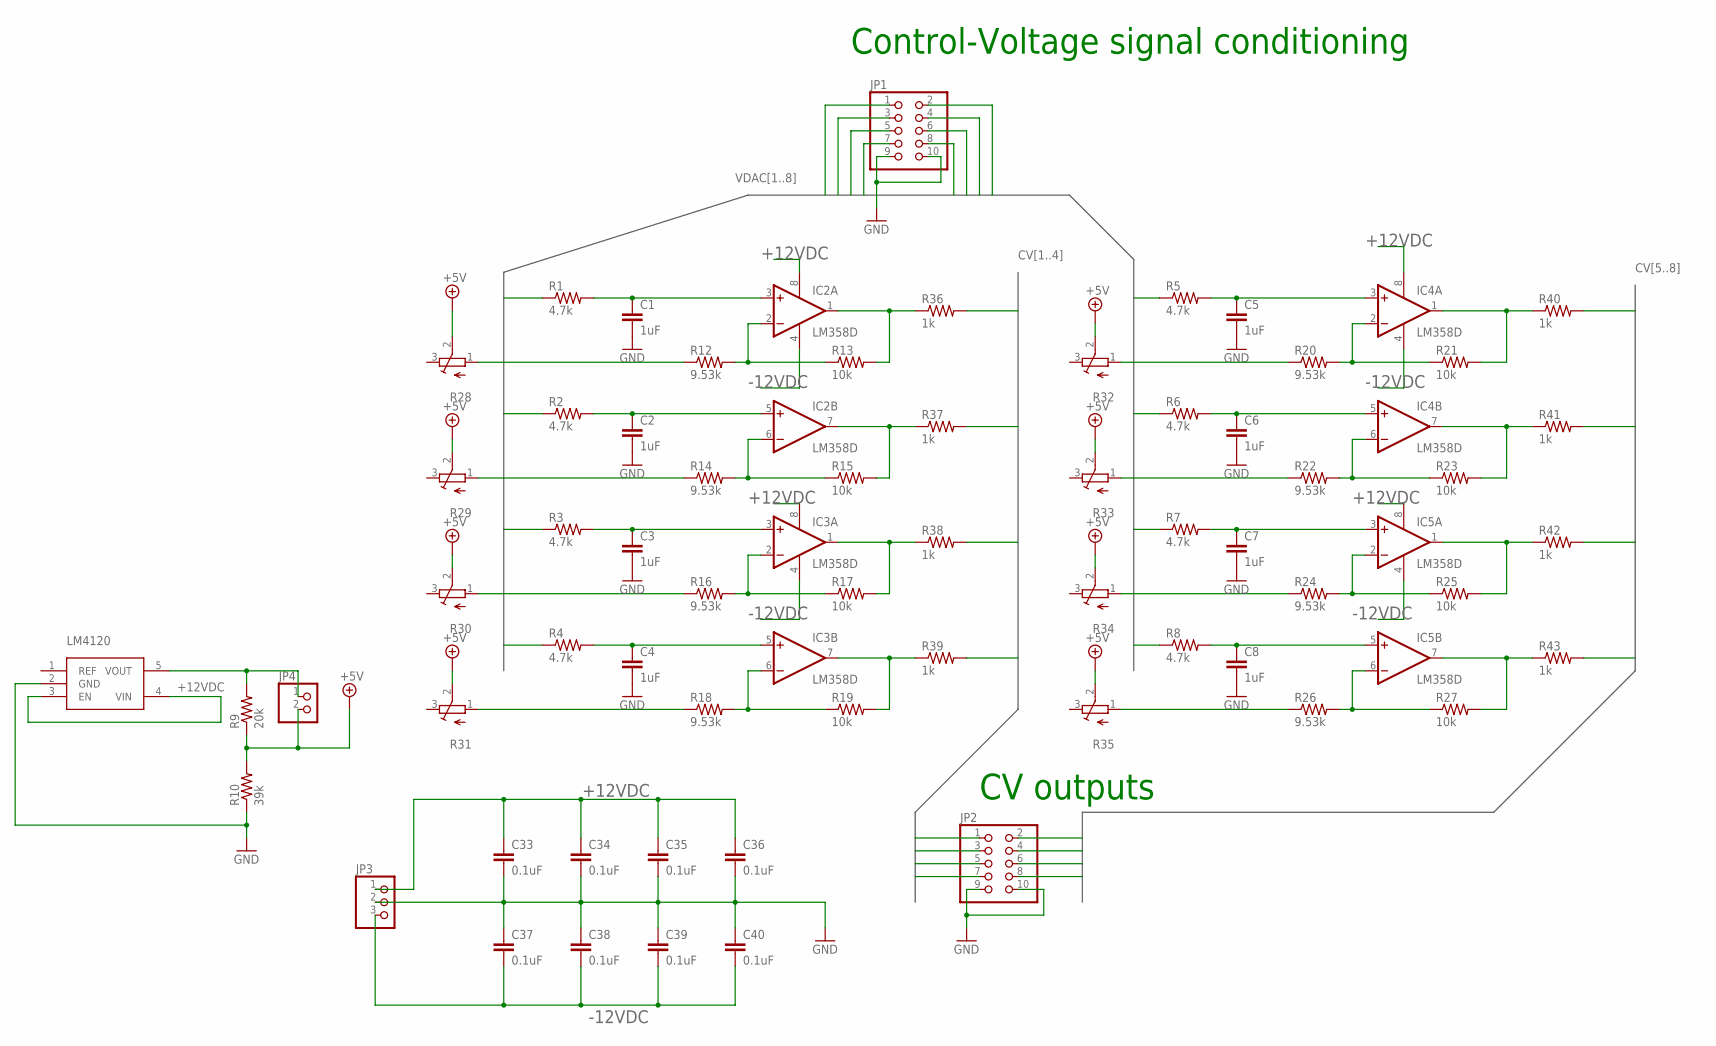
[picture p13: schematic CV-module-schematics.sch]

Parts:
C1, C2, C3, C4, C5, C6, C7, C8: 1uF; C0603
C33, C34, C35, C36, C37, C38, C39, C40: 0.1uF; C0603
IC2, IC3, IC4, IC5: LM358D; SO08
JP1, JP2: PINHD-2X5; 2X05
JP3: PINHD-1X3; 1X03
JP4: PINHD-1X2; 1X02
LM4120: LM4120; SOT23-5
R1, R2, R3, R4, R5, R6, R7, R8: 4.7k; R0603
R9: 20k; R0603
R10: 39k; R0603
R12, R14, R16, R18, R20, R22, R24, R26: 9.53k; R0603
R13, R15, R17, R19, R21, R23, R25, R27: 10k; R0603
R28, R29, R30, R31, R32, R33, R34, R35: TRIM_EU-3222W; 3222W
R36, R37, R38, R39, R40, R41, R42, R43: 1k; R0603

Connections:
+5V: JP4.2, R9.1, R10.2, R28.2 (S), R29.2 (S), R30.2 (S), R31.2 (S), R32.2 (S), R33.2 (S), R34.2 (S), R35.2 (S)
+12VDC: C33.1, C34.1, C35.1, C36.1, IC2.8 (V+), IC3.8 (V+), IC4.8 (V+), IC5.8 (V+), JP3.1, LM4120.3 (EN), LM4120.4 (VIN)
-12VDC: C37.2, C38.2, C39.2, C40.2, IC2.4 (V-), IC3.4 (V-), IC4.4 (V-), IC5.4 (V-), JP3.3
CV1: JP2.1, R37.2
CV2: JP2.3, R36.2
CV3: JP2.5, R39.2
CV4: JP2.7, R38.2
CV5: JP2.2, R42.2
CV6: JP2.4, R43.2
CV7: JP2.6, R40.2
CV8: JP2.8, R41.2
GND: C1.2, C2.2, C3.2, C4.2, C5.2, C6.2, C7.2, C8.2, C33.2, C34.2, C35.2, C36.2, C37.1, C38.1, C39.1, C40.1, JP1.9, JP1.10, JP2.9, JP2.10, JP3.2, LM4120.2 (GND), R10.1
unnamed: C1.1, IC2.3 (+IN), R1.2
unnamed: C2.1, IC2.5 (+IN), R2.2
unnamed: C3.1, IC3.3 (+IN), R3.2
unnamed: IC2.2 (-IN), R12.2, R13.1
unnamed: R12.1, R28.1 (A)
unnamed: IC2.1 (OUT), R13.2, R36.1
unnamed: R14.1, R29.1 (A)
unnamed: IC2.6 (-IN), R14.2, R15.1
unnamed: IC3.2 (-IN), R16.2, R17.1
unnamed: R16.1, R30.1 (A)
unnamed: IC3.6 (-IN), R18.2, R19.1
unnamed: R18.1, R31.1 (A)
unnamed: IC3.7 (OUT), R19.2, R39.1
unnamed: IC3.1 (OUT), R17.2, R38.1
unnamed: IC2.7 (OUT), R15.2, R37.1
unnamed: IC4.2 (-IN), R20.2, R21.1
unnamed: IC4.1 (OUT), R21.2, R40.1
unnamed: IC4.7 (OUT), R23.2, R41.1
unnamed: IC4.6 (-IN), R22.2, R23.1
unnamed: IC5.2 (-IN), R24.2, R25.1
unnamed: IC5.1 (OUT), R25.2, R42.1
unnamed: R24.1, R34.1 (A)
unnamed: IC5.6 (-IN), R26.2, R27.1
unnamed: IC5.7 (OUT), R27.2, R43.1
unnamed: R26.1, R35.1 (A)
unnamed: R20.1, R32.1 (A)
unnamed: R22.1, R33.1 (A)
unnamed: C4.1, IC3.5 (+IN), R4.2
unnamed: C5.1, IC4.3 (+IN), R5.2
unnamed: C6.1, IC4.5 (+IN), R6.2
unnamed: C7.1, IC5.3 (+IN), R7.2
unnamed: C8.1, IC5.5 (+IN), R8.2
unnamed: JP4.1, LM4120.5 (VOUT), R9.2
VDAC1: JP1.1, R1.1
VDAC2: JP1.2, R2.1
VDAC3: JP1.3, R3.1
VDAC4: JP1.4, R4.1
VDAC5: JP1.5, R5.1
VDAC6: JP1.6, R6.1
VDAC7: JP1.7, R7.1
VDAC8: JP1.8, R8.1

Notes on the sheet:
Control-Voltage signal conditioning
CV outputs

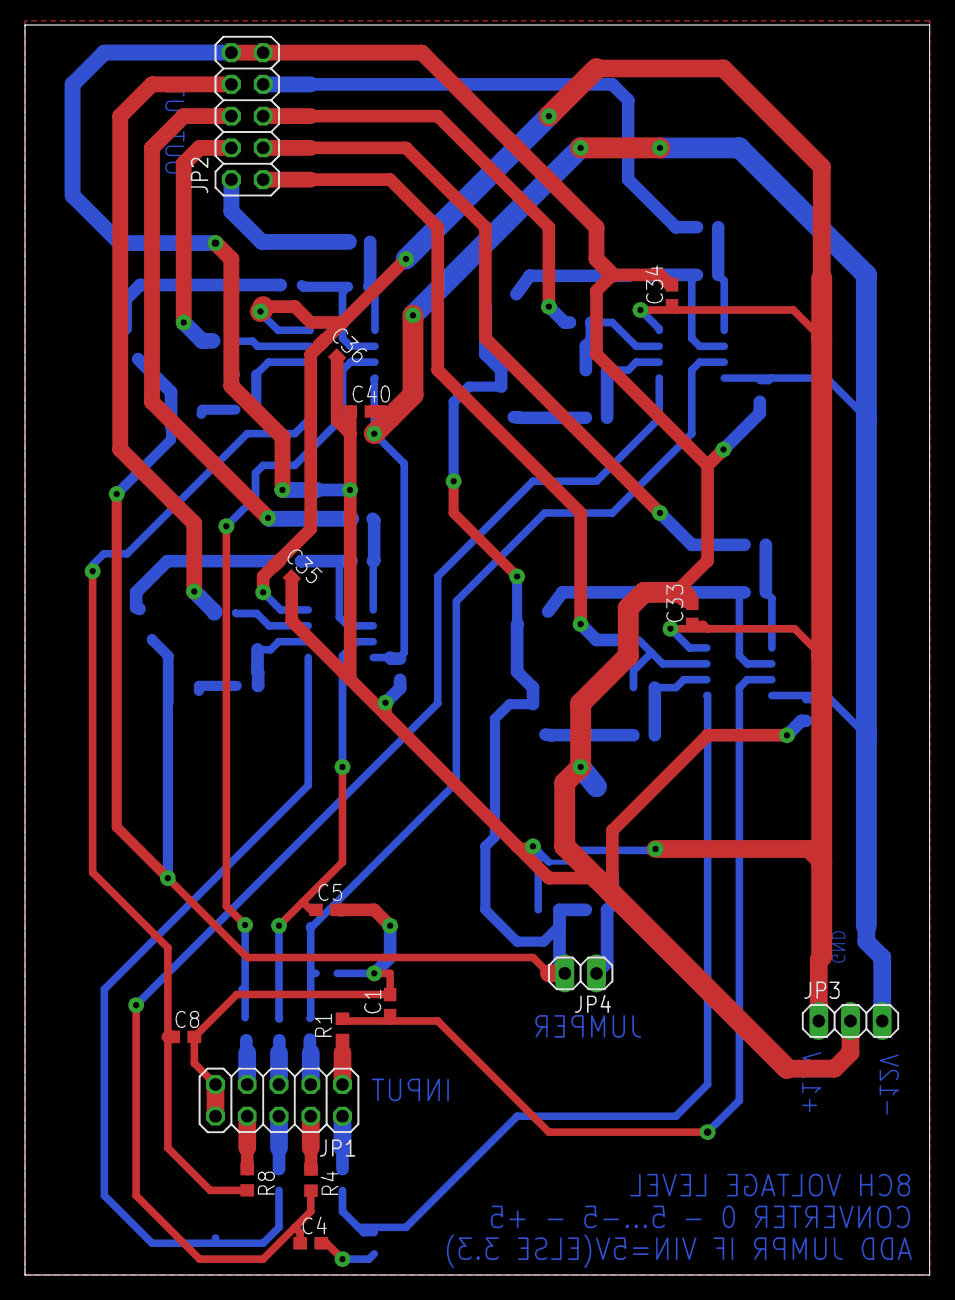
[picture p14: board CV-module-schematics.brd from above]

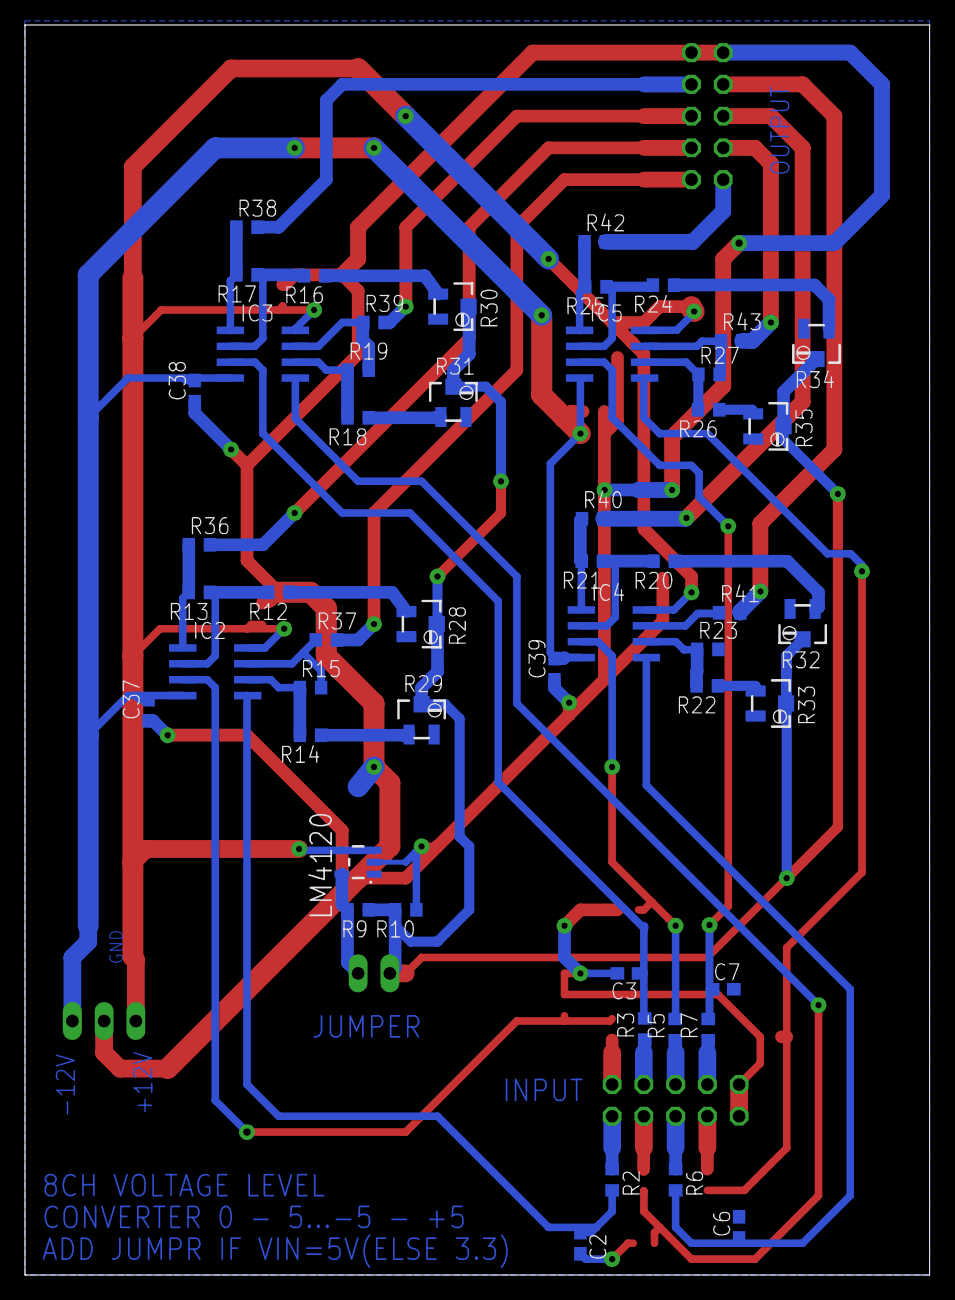
[picture p15: board CV-module-schematics.brd from below]

Board: 2 copper layers, 72.4 x 100.0 mm, 67 parts (51 on the bottom side), 53 nets.
