hartikap/ProjectWork/(commit log)

2015-10-29 Part-list and links added
    [Farnell-parts.ods]
2015-11-02 Partlist updated
    [Farnell-parts.ods]
2015-11-02 Added folders etc
    [Farnell-parts.ods]
2015-11-03 Added eagle project for CV-Module
    [CV-module-schematics.brd, CV-module-schematics.sch]
2015-11-04 working on eagle-project
    [CV-module-schematics.sch, Farnell-parts.ods]
2015-11-11 HW-design phase
    [CV-module-schematics.brd, CV-module-schematics.sch, Farnell-parts.ods]
2015-11-11 eagle project forward
    [CV-module-schematics.brd, CV-module-schematics.sch, Farnell-parts.ods]
2015-11-12 HW schematics and layout +parts updated
    [CV-module-schematics.brd, CV-module-schematics.sch, Farnell-parts.ods]
2015-11-13 Schema and Layout
    [CV-module-schematics.brd, CV-module-schematics.sch, Farnell-parts.ods]
2015-11-16 layout forward
    [CV-module-schematics.brd, CV-module-schematics.sch, Farnell-parts.ods]
2015-11-17 Schema and layout design
    [CV-module-schematics.brd, CV-module-schematics.sch, Farnell-parts.ods]
2015-11-19 Schemas and layout updated
    [ADC-Board-schematics.brd, ADC-Board-schematics.sch, CV-module-schematics.brd, CV-module-schematics.sch, Farnell-parts.ods]
2015-12-06 front end and arduino code
2015-12-16 arduino code update
2015-12-17 arduino code
2015-12-18 arduino code updated
2016-01-06 updates for voltage-level module
    [CV-module-schematics.brd, CV-module-schematics.sch, Farnell-parts.ods]
2016-01-17 tvs considerations
    [ADC-Board-schematics.brd, ADC-Board-schematics.sch, Farnell-parts.ods]
2016-02-28 some hw changes
    [ADC-Board-schematics.brd, ADC-Board-schematics.sch, Farnell-parts.ods]
2016-03-09 Layout and parts
    [ADC-Board-schematics.brd, ADC-Board-schematics.sch, Farnell-parts.ods]
2016-03-10 ADC-board layout
    [ADC-Board-schematics.brd, ADC-Board-schematics.sch]
